Bob264264/Experimental-Mars-Robot/interface/web_interface/electronics/Actuator Data.xlsx

Sheet: Sheet4
SUMMARY OUTPUT
Regression Statistics
Multiple R | 0.9997072639
R Square | 0.9994146135
Adjusted R Square | 0.9993755878
Standard Error | 0.6669676652
Observations | 17
ANOVA
 | df | SS | MS | F | Significance F
Regression | 1 | 11392.10154 | 11392.10154 | 25609.09833 | 1.155031198e-25
Residual | 15 | 6.672687996 | 0.4448458664
Total | 16 | 11398.77422
 | Coefficients | Standard Error | t Stat | P-value | Lower 95% | Upper 95% | Lower 95.0% | Upper 95.0%
Intercept | 0.5874132888 | 0.4841623047 | 1.213256966 | 0.2437918728 | -0.4445542356 | 1.619380813 | -0.4445542356 | 1.619380813
X Variable 1 | 0.8996115754 | 0.005621573471 | 160.0284298 | 1.155031198e-25 | 0.8876294752 | 0.9115936756 | 0.8876294752 | 0.9115936756
RESIDUAL OUTPUT
Observation | Predicted Y | Residuals
1 | 63.56022357 | 0.7197764313
2 | 77.0543972 | -1.2843972
3 | 90.54857083 | 0.3114291684
4 | 104.0427445 | 0.307255537
5 | 77.0543972 | -0.9243972002
6 | 108.5408023 | 0.6391976598
7 | 54.56410781 | -0.08410781446
8 | 81.55245508 | -0.7924550773
9 | 104.0427445 | -0.212744463
10 | 45.56799206 | 0.6620079398
11 | 41.06993418 | -0.569934183
12 | 72.55633932 | -0.676339323
13 | 90.54857083 | 0.5914291684
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
