Bob264264/Experimental-Mars-Robot/interface/recognition/image/image1.png

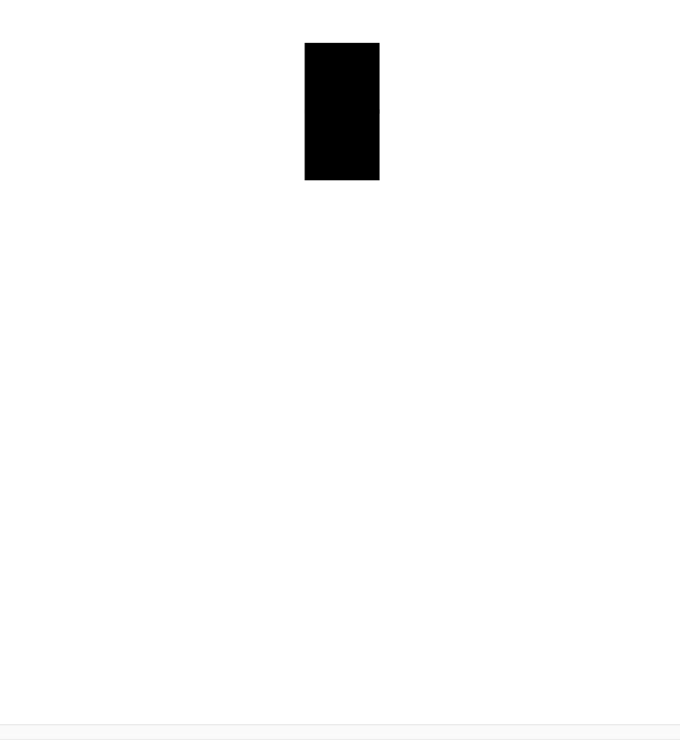
interface/recognition/image/image1.png
