Bob264264/Experimental-Mars-Robot/interface/recognition/image/image2.png

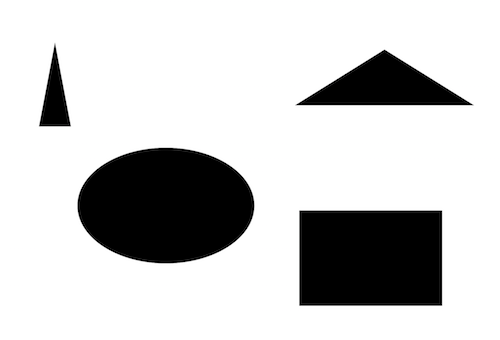
interface/recognition/image/image2.png
