Bob264264/Experimental-Mars-Robot/interface/recognition/template/template1.png

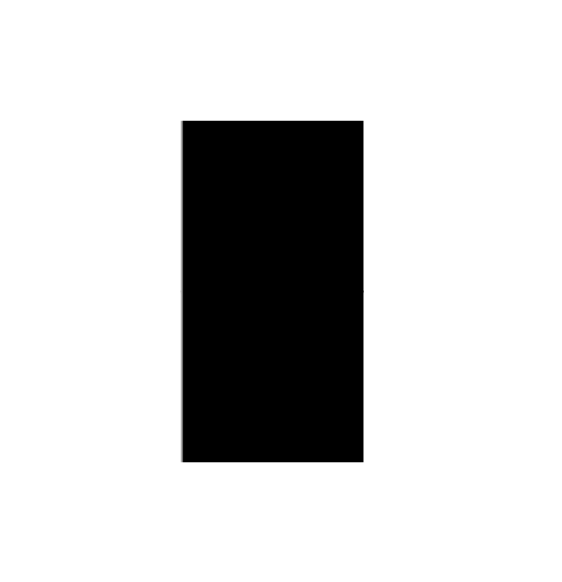
interface/recognition/template/template1.png
