Bob264264/Experimental-Mars-Robot/interface/recognition/template/template2.png

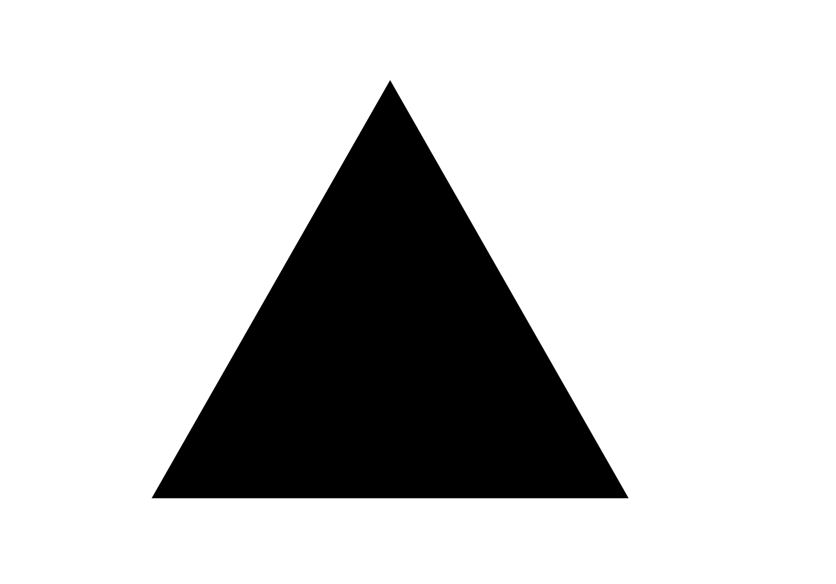
interface/recognition/template/template2.png
