Bob264264/Experimental-Mars-Robot/models/actuator/actuator assembly.SLDASM

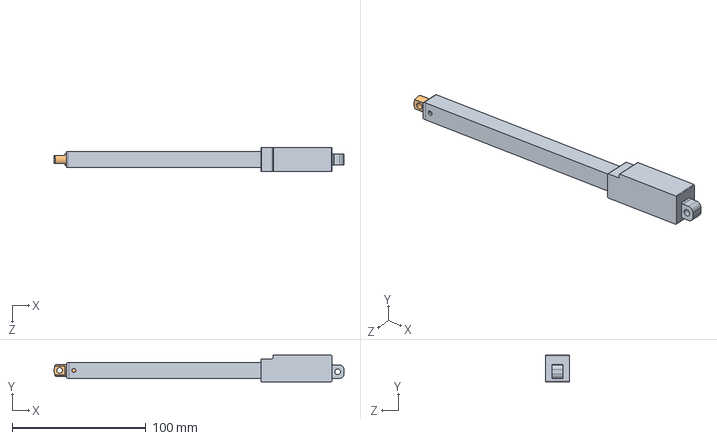
[picture p18: CAD file, 2016-07-16]
models/actuator/actuator assembly.SLDASM
217.0 x 20.0 x 18.0 mm
actuator body
actuator arm
