Bob264264/Experimental-Mars-Robot/models/wheel design v4/wheel UNDIMENSIONED.SLDASM

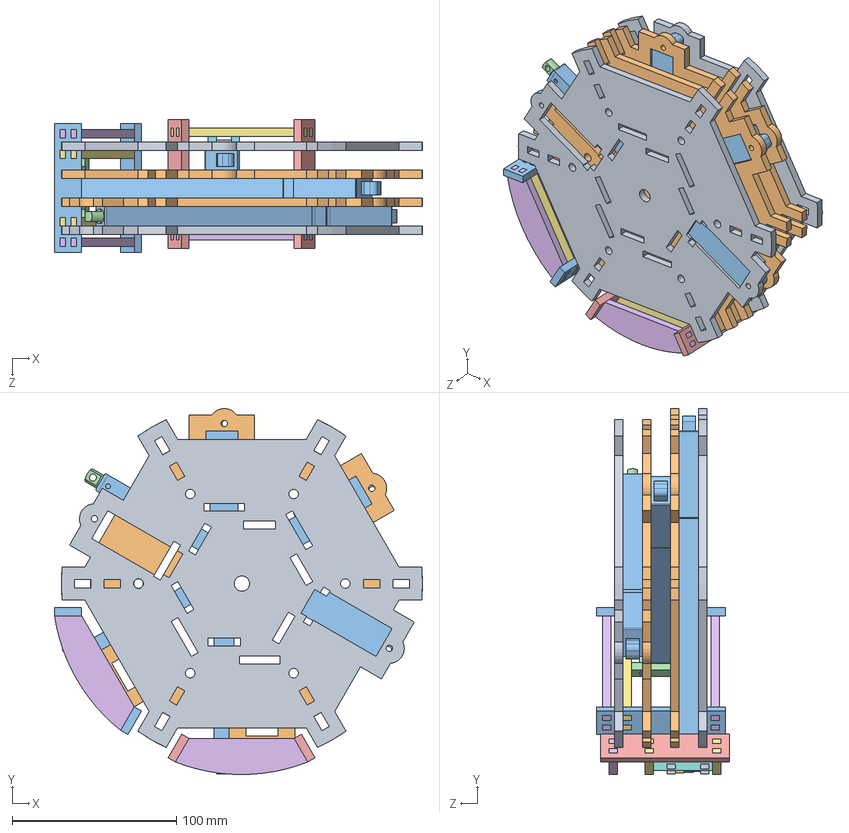
[picture p19: CAD file, 2016-07-16]
models/wheel design v4/wheel UNDIMENSIONED.SLDASM
224.2 x 223.0 x 80.9 mm
end wheel plate UNDIMENSIONED x 2
center wheel plate UNDIMENSIONED x 2
actuator body x 3
actuator arm x 3
OuterActuatorSidePlate x 2
SpanningPlate x 3
ConnectingPlate x 4
OuterActuatorSpanner x 2
SpacerBoltConnector x 4
A-Spacer x 4
CentralActuatorSidePlate x 2
CentralActuatorSpanner x 2
