Bob264264/Experimental-Mars-Robot/models/wheel design v4/foot/newFootAssemblyForEndActuators.SLDASM

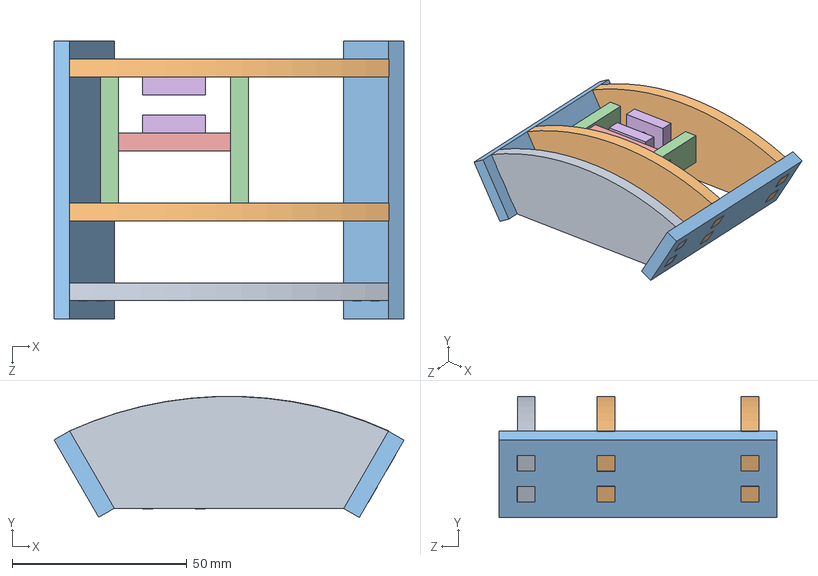
[picture p20: CAD file, 2016-07-16]
models/wheel design v4/foot/newFootAssemblyForEndActuators.SLDASM
100.0 x 34.6 x 79.4 mm
newFootWithTabs
newFootWithTabsWithCutout x 2
newFootConnector x 2
connectorToMidPlateAndEndPlate - Copy x 2
connectorToSpacerA
spacerA x 2
