Bob264264/Experimental-Mars-Robot/models/wheel design v4/foot/centralFootAssembly.SLDASM

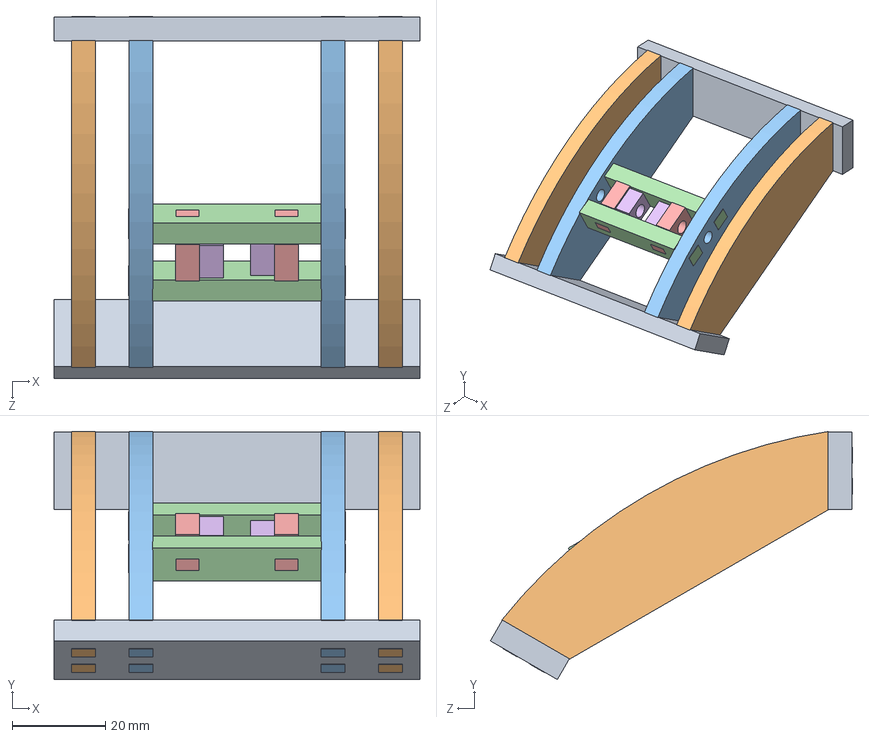
[picture p21: CAD file, 2016-07-16]
models/wheel design v4/foot/centralFootAssembly.SLDASM
78.4 x 53.2 x 77.6 mm
CentralActuatorSidePlate x 2
SpanningPlate x 2
ConnectingPlate x 2
CentralActuatorSpanner x 2
SpacerBoltConnector x 2
A-Spacer x 2
