Bob264264/Experimental-Mars-Robot/models/wheel design v4/foot/outerFootAssembly.SLDASM

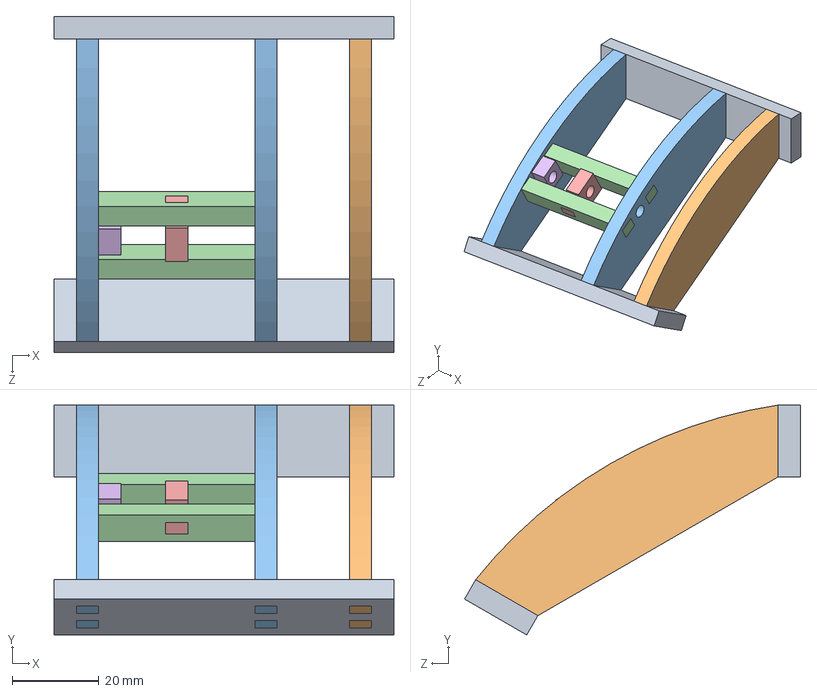
[picture p22: CAD file, 2016-07-16]
models/wheel design v4/foot/outerFootAssembly.SLDASM
78.4 x 53.0 x 77.5 mm
OuterActuatorSidePlate x 2
SpanningPlate
ConnectingPlate x 2
OuterActuatorSpanner x 2
SpacerBoltConnector
A-Spacer
