Bob264264/Experimental-Mars-Robot/models/wheel design v4/foot/newFootAssemblyMiddleActuators.SLDASM

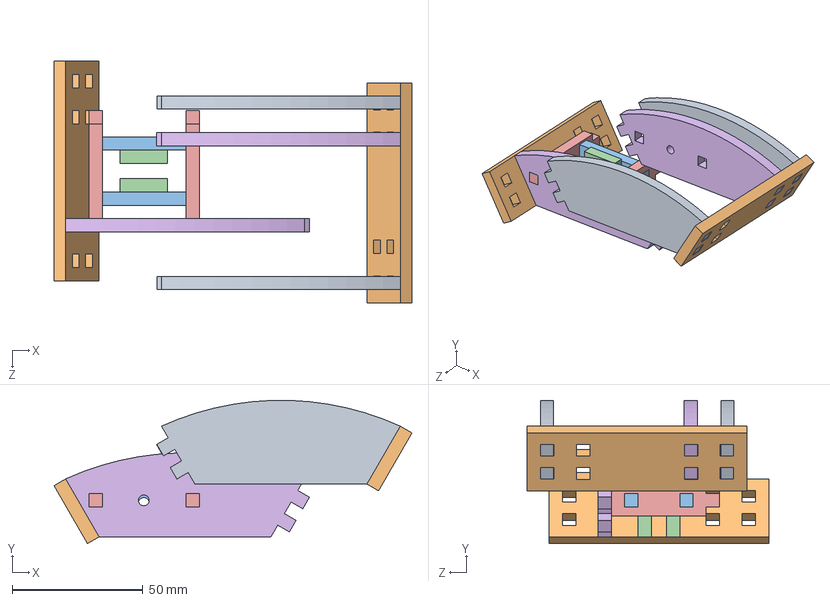
[picture p24: CAD file, 2016-07-12]
models/wheel design v4/foot/newFootAssemblyMiddleActuators.SLDASM
136.7 x 54.7 x 92.3 mm
newFootWithTabs x 2
newFootConnectorForMiddlePlate x 2
connectorToSpacerA x 2
spacerA x 2
connectorToMidPlatesAndConnector x 2
newFootWithTabsWithCutout x 2
