Bob264264/Experimental-Mars-Robot/models/wheel design v4/foot/actuatorAttachmentAssembly.SLDASM

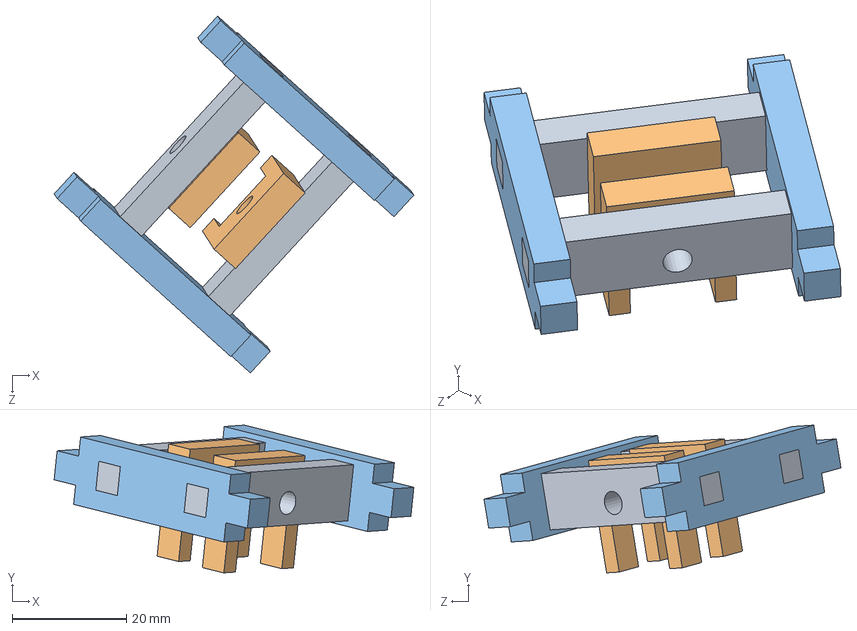
[picture p25: CAD file, 2016-07-11]
models/wheel design v4/foot/actuatorAttachmentAssembly.SLDASM
62.9 x 25.9 x 62.4 mm
connectorToSpacerA x 2
spacerA x 2
connectorToMidPlatesAndConnector x 2
