Bob264264/Experimental-Mars-Robot/models/wheel design v4/drawings/proximal_actuator_shaft_support_center.DXF

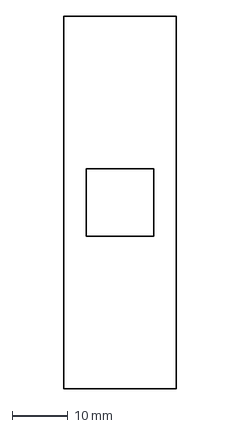
[picture p26: CAD file, 2016-07-13]
models/wheel design v4/drawings/proximal_actuator_shaft_support_center.DXF
20.2 x 67.0 mm
