Bob264264/Experimental-Mars-Robot/models/wheel design v4/end wheel plate UNDIMENSIONED.SLDPRT

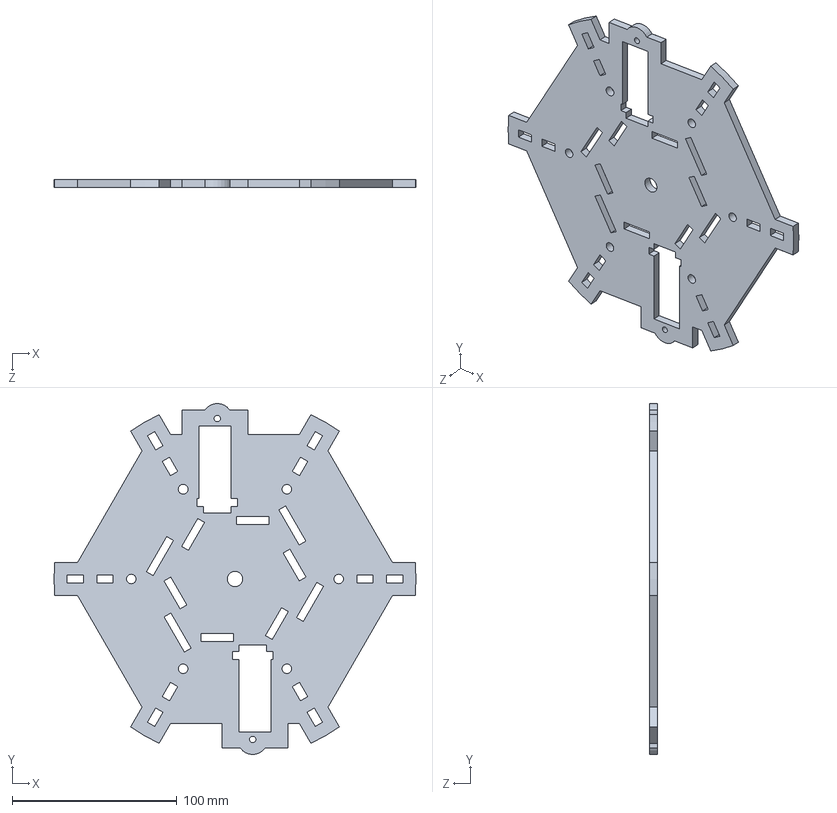
[picture p27: CAD file, 2016-07-16]
models/wheel design v4/end wheel plate UNDIMENSIONED.SLDPRT
220.0 x 213.3 x 5.15 mm
