Bob264264/Experimental-Mars-Robot/models/wheel design v4/foot/CentralActuatorSpanner.SLDPRT

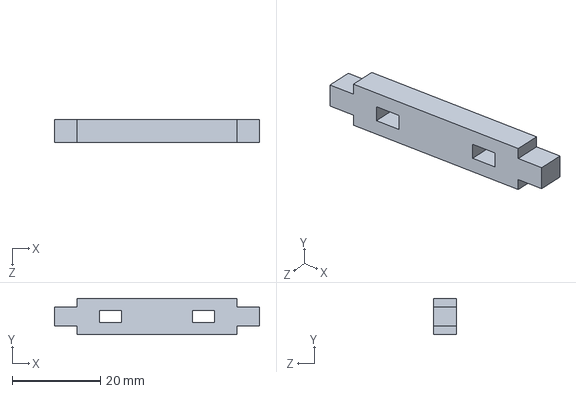
[picture p28: CAD file, 2016-07-16]
models/wheel design v4/foot/CentralActuatorSpanner.SLDPRT
46.5 x 8.20 x 5.15 mm
