Bob264264/Experimental-Mars-Robot/models/wheel design v4/foot/kerfed/A-Spacer.DXF

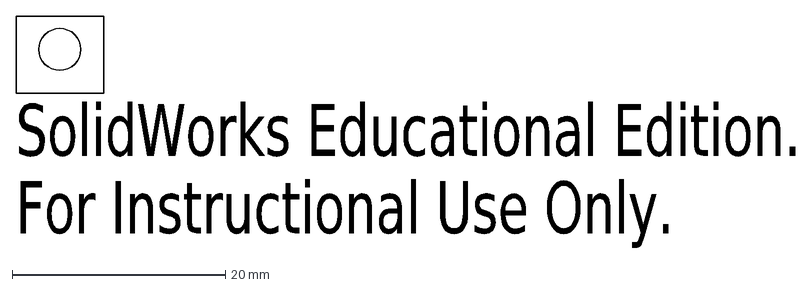
[picture p29: CAD file, 2016-07-16]
models/wheel design v4/foot/kerfed/A-Spacer.DXF
SolidWorks Educational Edition.
For Instructional Use Only.
