Bob264264/Experimental-Mars-Robot/models/actuator/actuator body.SLDPRT

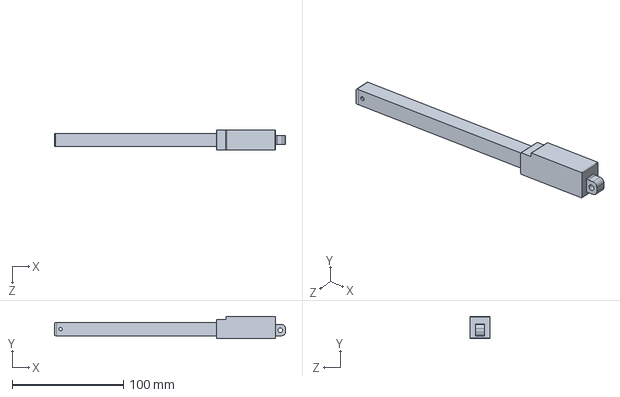
[picture p30: CAD file, 2016-07-13]
models/actuator/actuator body.SLDPRT
207.7 x 20.0 x 18.0 mm
