Bob264264/Experimental-Mars-Robot/models/wheel design v4/drawings/distal_e_connector_bracket.DXF

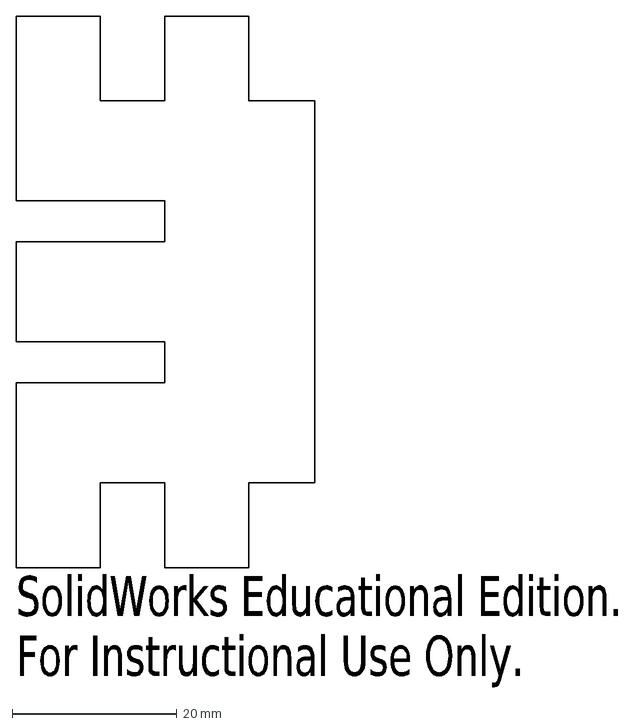
[picture p31: CAD file, 2016-07-13]
models/wheel design v4/drawings/distal_e_connector_bracket.DXF
SolidWorks Educational Edition.
For Instructional Use Only.
