Bob264264/Experimental-Mars-Robot/models/wheel design v4/foot/CentralActuatorSidePlate.SLDPRT

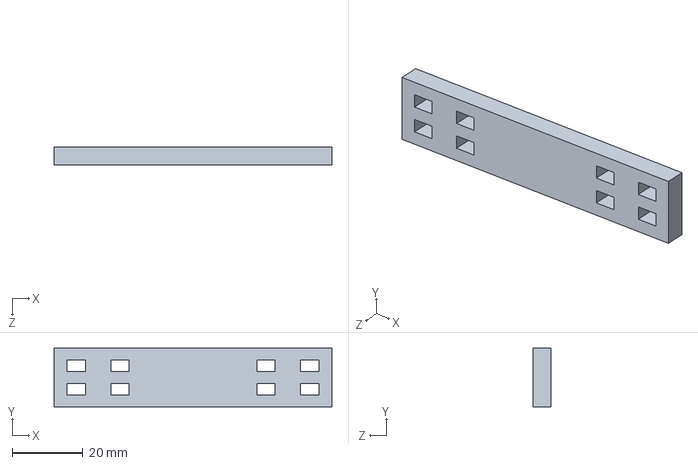
[picture p32: CAD file, 2016-07-16]
models/wheel design v4/foot/CentralActuatorSidePlate.SLDPRT
78.4 x 16.6 x 5.15 mm
