Bob264264/Experimental-Mars-Robot/models/actuator/actuator arm.SLDPRT

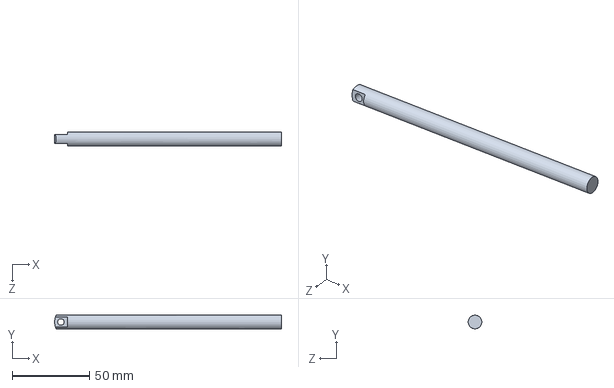
[picture p34: CAD file, 2016-07-11]
models/actuator/actuator arm.SLDPRT
147.3 x 8.90 x 8.90 mm
