Bob264264/Experimental-Mars-Robot/models/wheel design v4/drawings/proximal_actuator_body_support_center.DXF

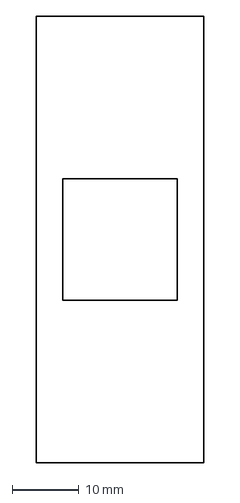
[picture p35: CAD file, 2016-07-13]
models/wheel design v4/drawings/proximal_actuator_body_support_center.DXF
25.2 x 67.0 mm
