Bob264264/Experimental-Mars-Robot/models/wheel design v4/foot/kerfed/CentralActuatorSpanner.DXF

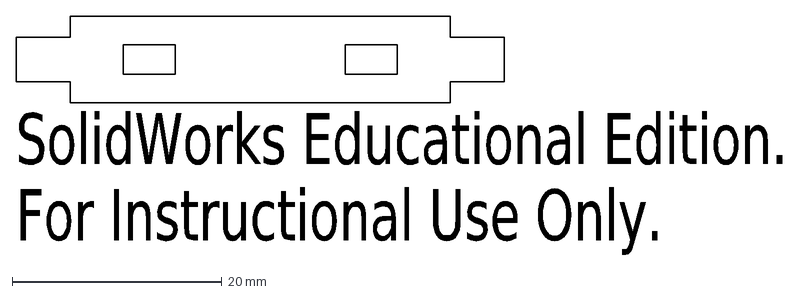
[picture p37: CAD file, 2016-07-16]
models/wheel design v4/foot/kerfed/CentralActuatorSpanner.DXF
SolidWorks Educational Edition.
For Instructional Use Only.
