Bob264264/Experimental-Mars-Robot/models/actuator/actuator mounting bracket.SLDPRT

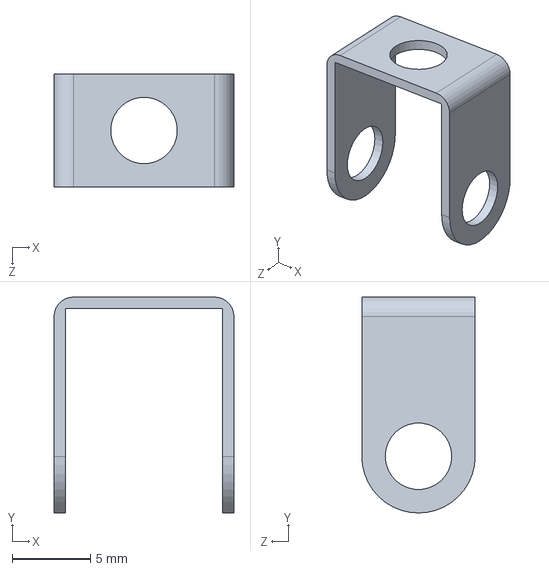
[picture p38: CAD file, 2016-07-03]
models/actuator/actuator mounting bracket.SLDPRT
11.5 x 13.8 x 7.25 mm
