Bob264264/Experimental-Mars-Robot/models/wheel design v4/foot/OuterActuatorSidePlate.SLDPRT

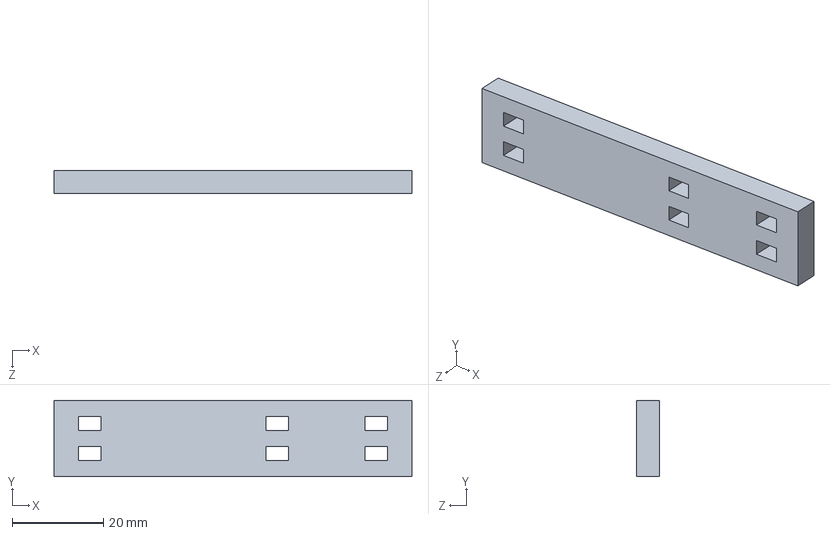
[picture p41: CAD file, 2016-07-16]
models/wheel design v4/foot/OuterActuatorSidePlate.SLDPRT
78.6 x 16.8 x 5.15 mm
