Bob264264/Experimental-Mars-Robot/models/wheel design v4/central wheel plate.SLDPRT

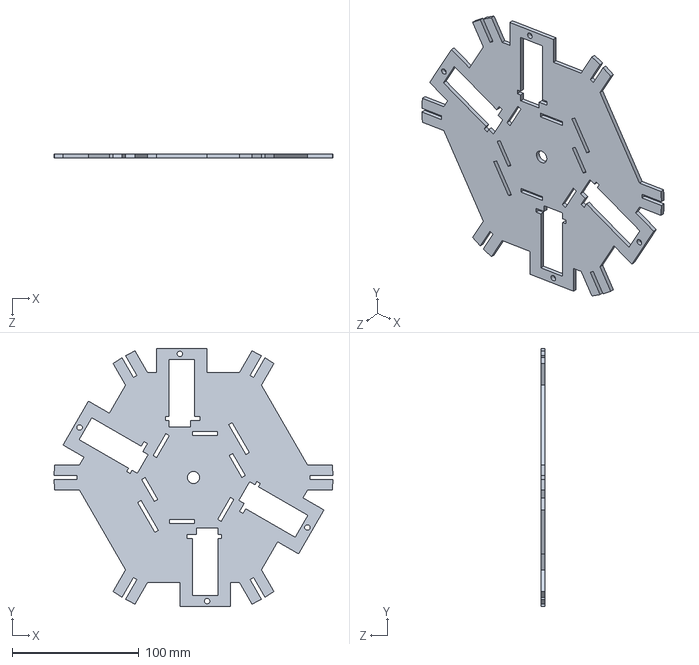
[picture p42: CAD file, 2016-07-13]
models/wheel design v4/central wheel plate.SLDPRT
220.0 x 203.8 x 3.17 mm
