Bob264264/Experimental-Mars-Robot/models/wheel design v4/drawings/end_wheel plate.DXF

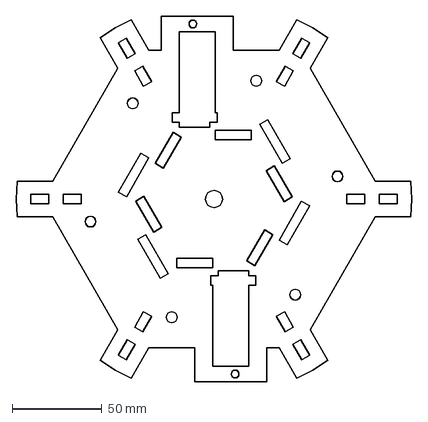
[picture p43: CAD file, 2016-07-13]
models/wheel design v4/drawings/end_wheel plate.DXF
220.3 x 203.7 mm
