Bob264264/Experimental-Mars-Robot/models/wheel design v4/foot/SpanningPlate.SLDPRT

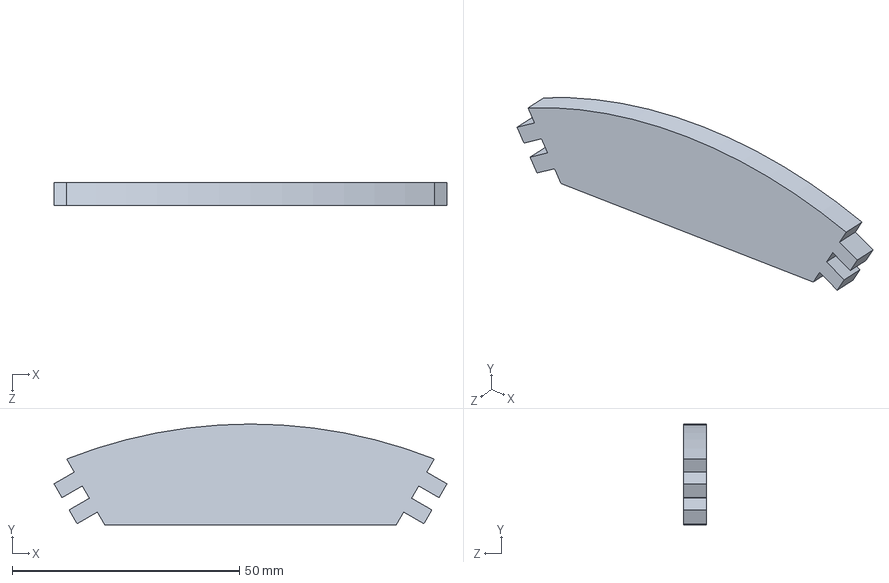
[picture p45: CAD file, 2016-07-16]
models/wheel design v4/foot/SpanningPlate.SLDPRT
86.5 x 22.2 x 5.15 mm
