Bob264264/Experimental-Mars-Robot/models/wheel design v4/drawings/proximal_actuator_shaft_support_side.DXF

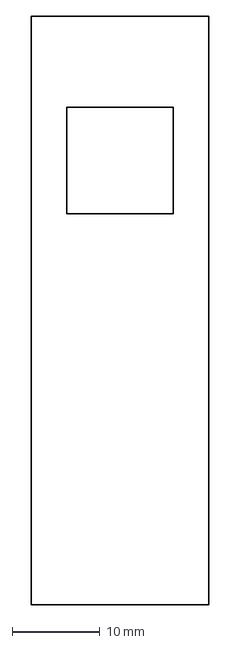
[picture p46: CAD file, 2016-07-13]
models/wheel design v4/drawings/proximal_actuator_shaft_support_side.DXF
20.2 x 67.0 mm
