Bob264264/Experimental-Mars-Robot/models/wheel design v4/proximal actuator shaft support side.SLDPRT

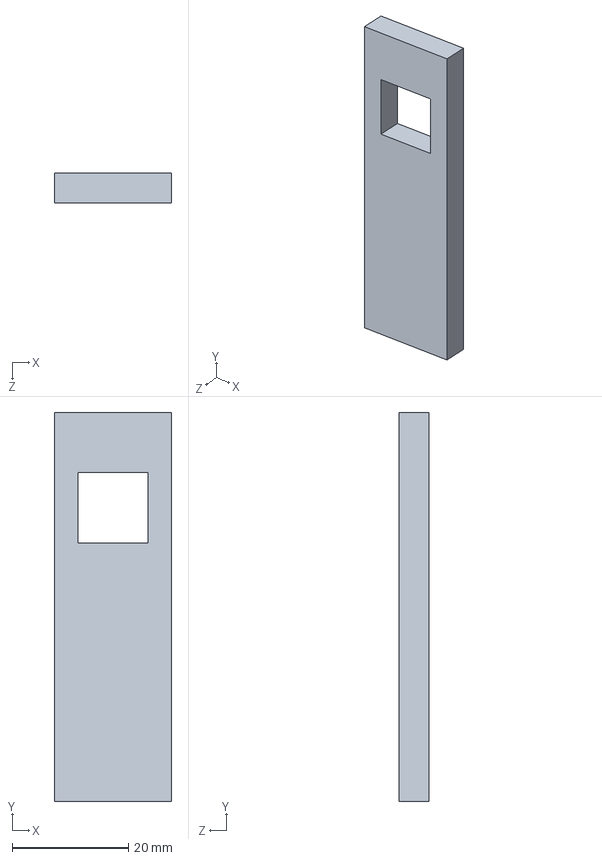
[picture p48: CAD file, 2016-07-13]
models/wheel design v4/proximal actuator shaft support side.SLDPRT
20.2 x 67.1 x 5.20 mm
