Bob264264/Experimental-Mars-Robot/models/wheel design v4/proximal actuator body support center.SLDPRT

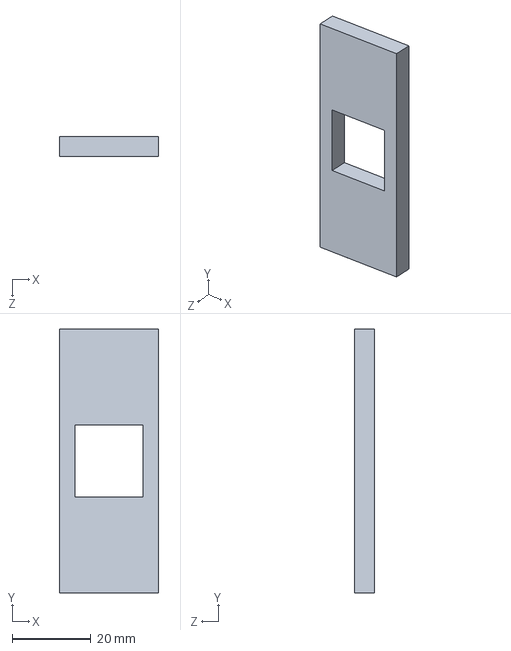
[picture p50: CAD file, 2016-07-13]
models/wheel design v4/proximal actuator body support center.SLDPRT
25.2 x 67.1 x 5.20 mm
