Bob264264/Experimental-Mars-Robot/models/wheel design v4/end wheel plate.SLDPRT

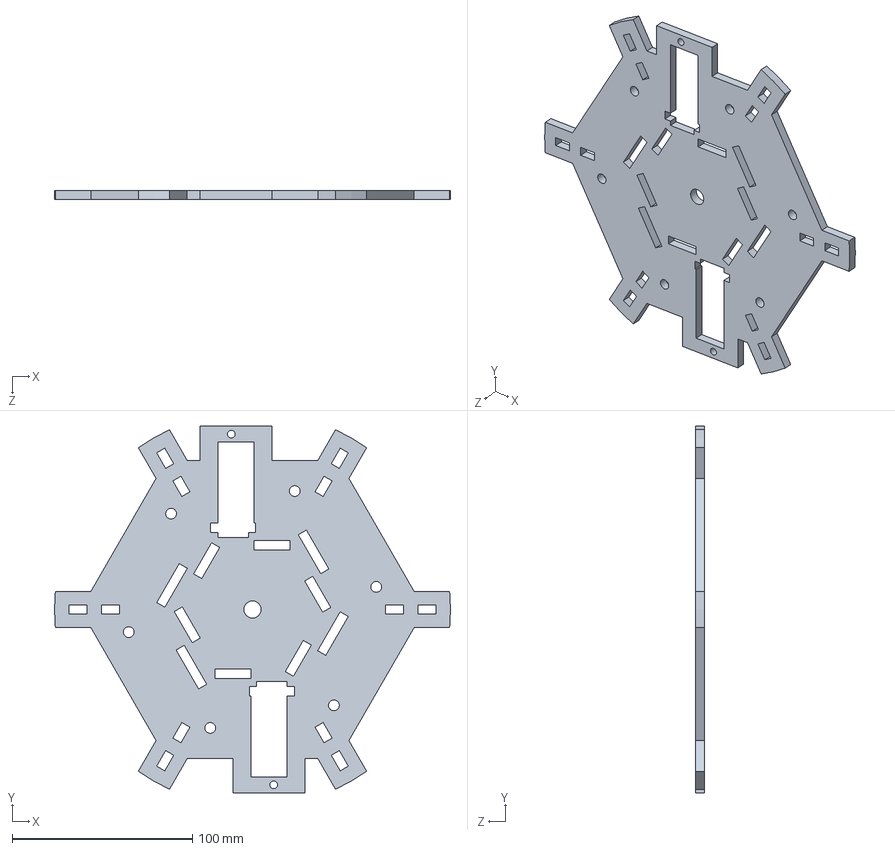
[picture p51: CAD file, 2016-07-13]
models/wheel design v4/end wheel plate.SLDPRT
220.0 x 203.7 x 5.20 mm
