Bob264264/Experimental-Mars-Robot/models/wheel design v4/foot/A-Spacer.SLDPRT

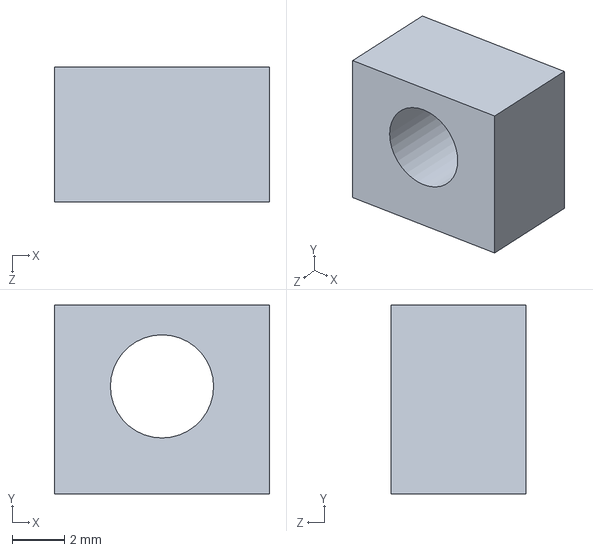
[picture p52: CAD file, 2016-07-16]
models/wheel design v4/foot/A-Spacer.SLDPRT
8.20 x 7.20 x 5.15 mm
