Bob264264/Experimental-Mars-Robot/models/wheel design v4/distal E connector bracket.SLDPRT

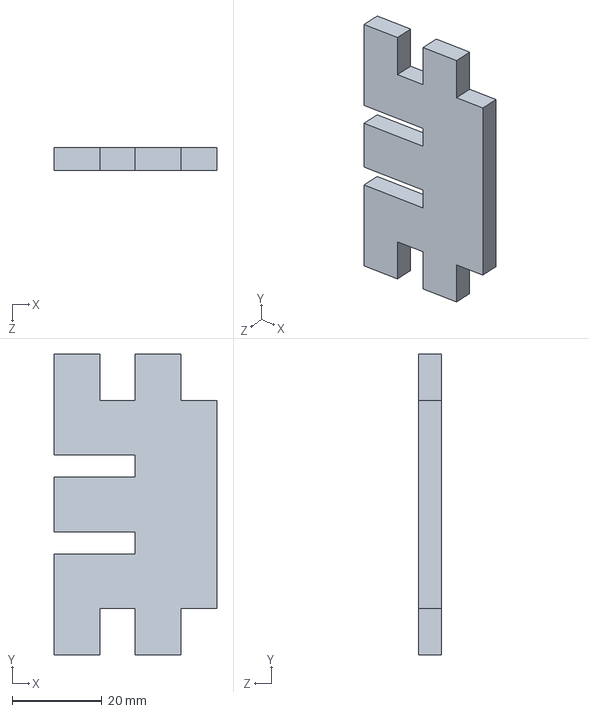
[picture p53: CAD file, 2016-07-13]
models/wheel design v4/distal E connector bracket.SLDPRT
36.2 x 67.0 x 5.15 mm
