Bob264264/Experimental-Mars-Robot/models/wheel design v4/foot/OuterActuatorSpanner.SLDPRT

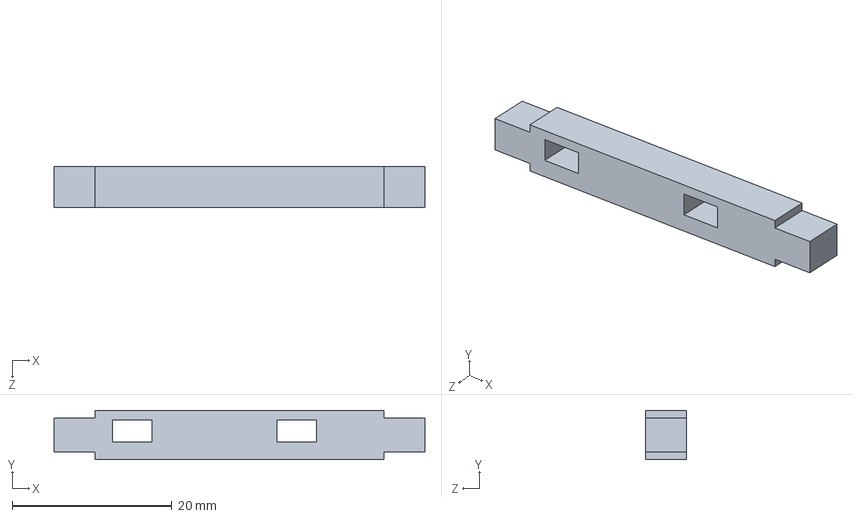
[picture p54: CAD file, 2016-07-16]
models/wheel design v4/foot/OuterActuatorSpanner.SLDPRT
46.5 x 6.20 x 5.15 mm
