Bob264264/Experimental-Mars-Robot/models/wheel design v4/foot/newFootWithTabsWithCutout.SLDPRT

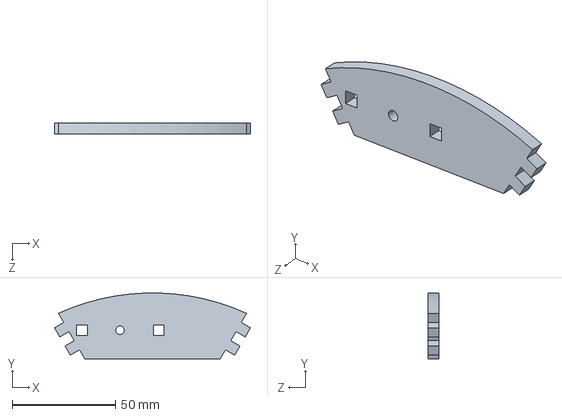
[picture p55: CAD file, 2016-07-11]
models/wheel design v4/foot/newFootWithTabsWithCutout.SLDPRT
95.0 x 32.0 x 5.15 mm
