Bob264264/Experimental-Mars-Robot/models/wheel design v4/foot/connectorToMidPlatesAndConnector.SLDPRT

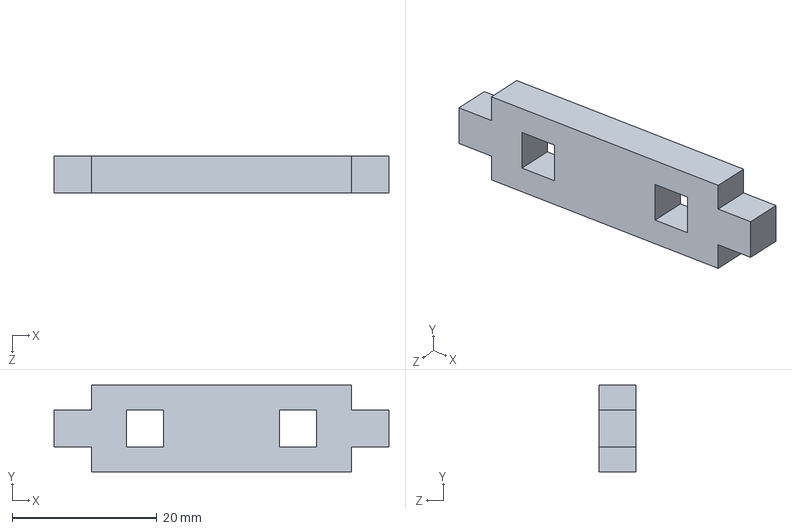
[picture p56: CAD file, 2016-07-11]
models/wheel design v4/foot/connectorToMidPlatesAndConnector.SLDPRT
46.3 x 12.0 x 5.15 mm
