Bob264264/Experimental-Mars-Robot/models/wheel design v4/foot/connectorToSpacerA.SLDPRT

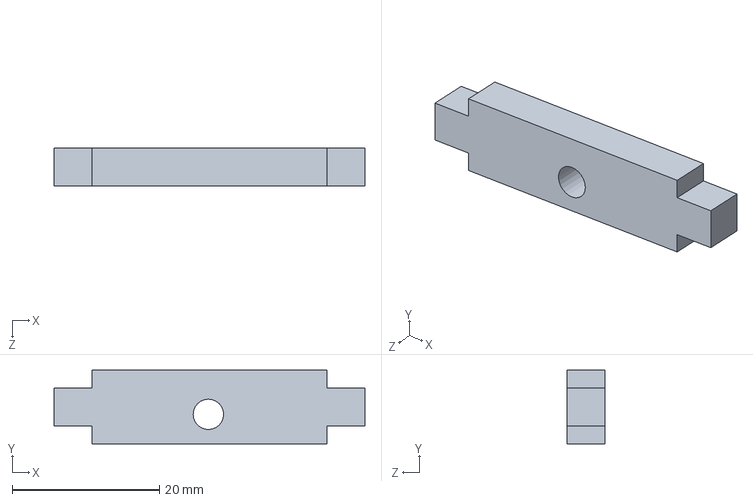
[picture p57: CAD file, 2016-07-11]
models/wheel design v4/foot/connectorToSpacerA.SLDPRT
42.3 x 10.0 x 5.15 mm
