Bob264264/Experimental-Mars-Robot/models/wheel design v4/foot/newFootConnector.SLDPRT

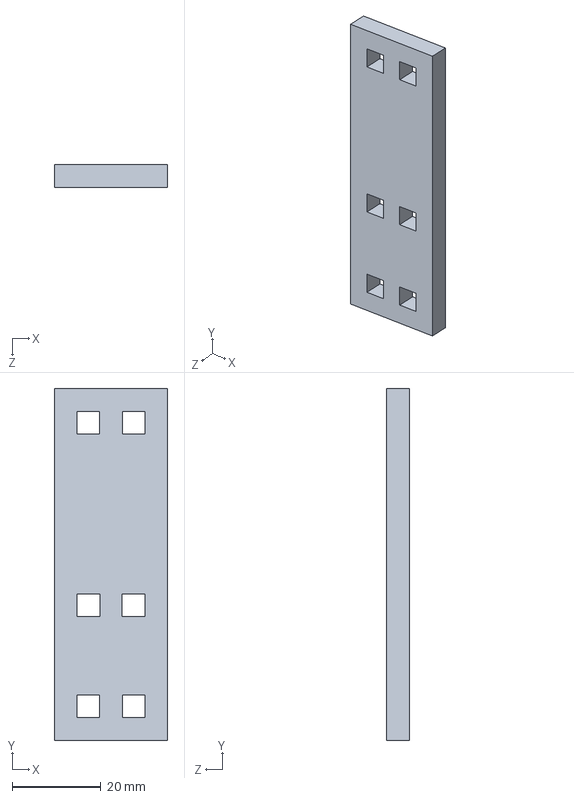
[picture p58: CAD file, 2016-07-11]
models/wheel design v4/foot/newFootConnector.SLDPRT
25.5 x 79.4 x 5.15 mm
