Bob264264/Experimental-Mars-Robot/models/wheel design v4/foot/connectorToMidPlateAndEndPlate - Copy.SLDPRT

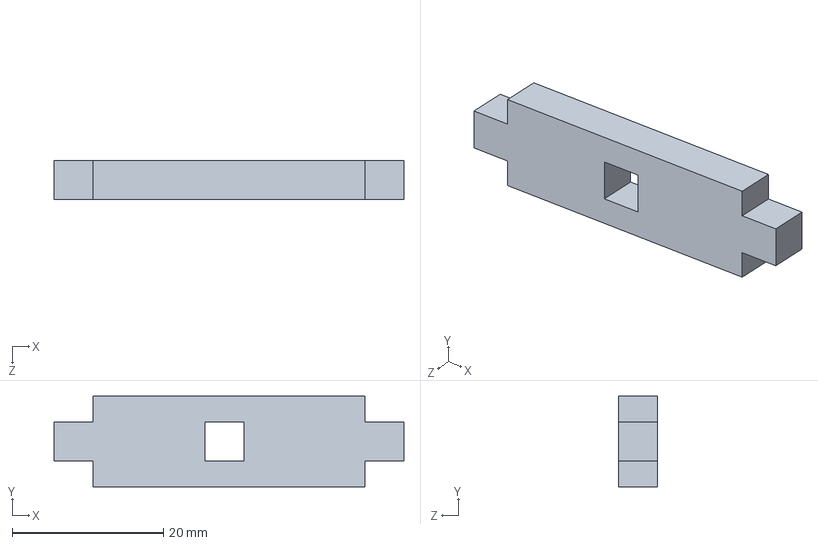
[picture p59: CAD file, 2016-07-11]
models/wheel design v4/foot/connectorToMidPlateAndEndPlate - Copy.SLDPRT
46.3 x 12.0 x 5.15 mm
