Bob264264/Experimental-Mars-Robot/models/wheel design v4/foot/spacerA.SLDPRT

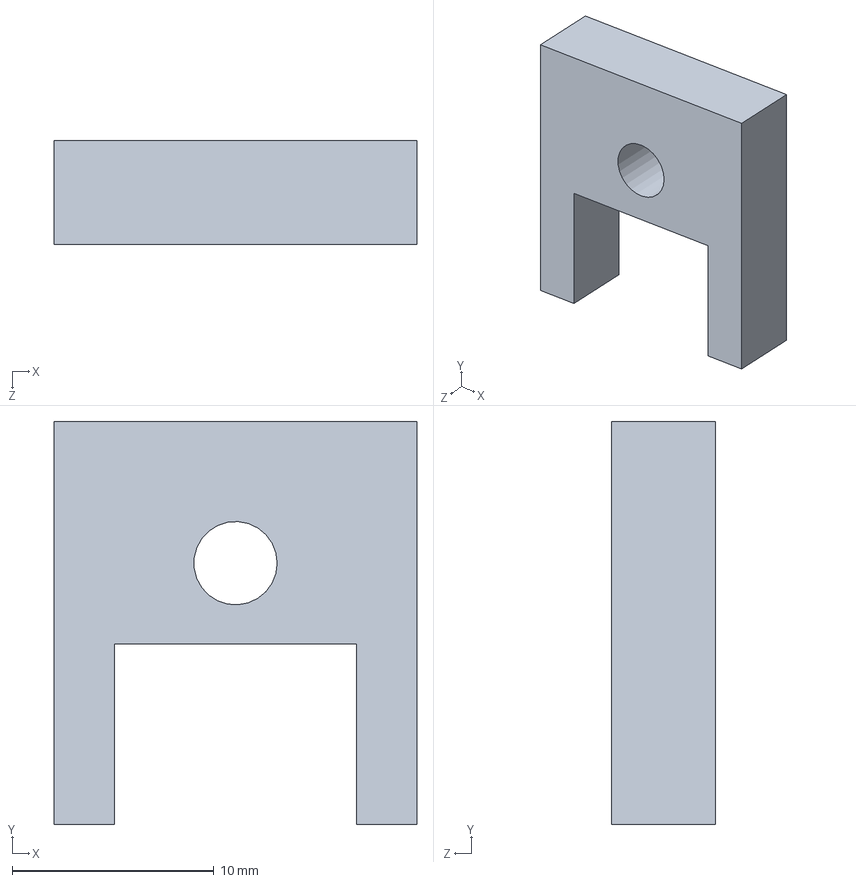
[picture p60: CAD file, 2016-07-11]
models/wheel design v4/foot/spacerA.SLDPRT
18.0 x 20.0 x 5.15 mm
