Bob264264/Experimental-Mars-Robot/models/wheel design v4/foot/newFootConnectorForMiddlePlate.SLDPRT

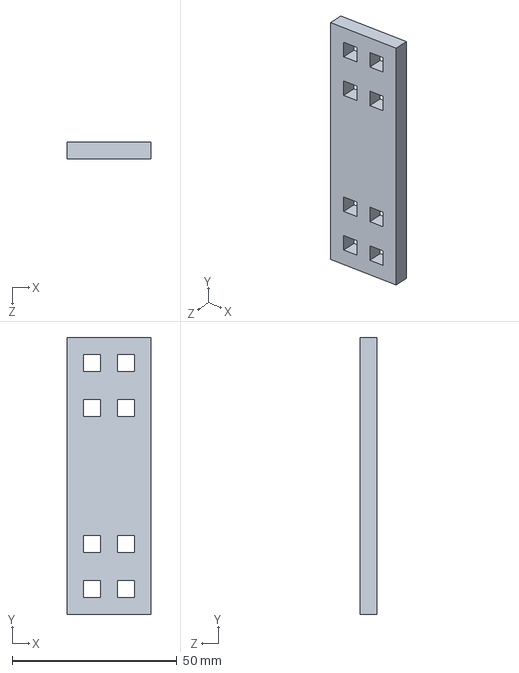
[picture p61: CAD file, 2016-07-11]
models/wheel design v4/foot/newFootConnectorForMiddlePlate.SLDPRT
25.5 x 84.0 x 5.15 mm
