Bob264264/Experimental-Mars-Robot/models/wheel design v4/foot/newFootWithTabs.SLDPRT

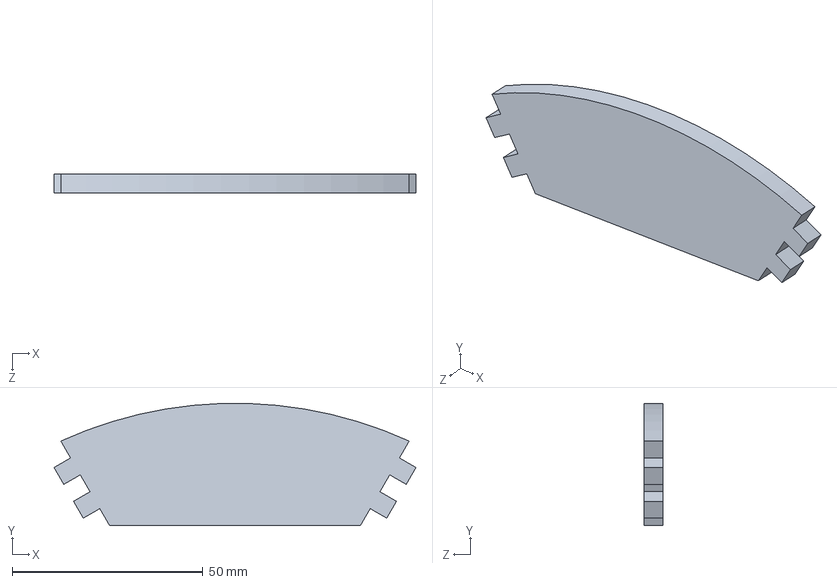
[picture p62: CAD file, 2016-07-11]
models/wheel design v4/foot/newFootWithTabs.SLDPRT
94.8 x 32.0 x 5.00 mm
