Bob264264/Experimental-Mars-Robot/models/wheel design v4/foot/newFootWithTabsWithCutoutMiddleActuator.SLDPRT

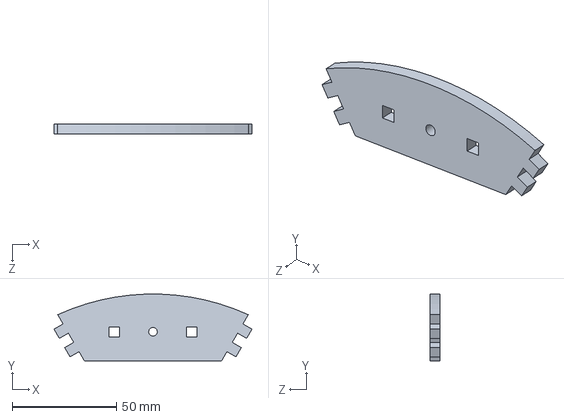
[picture p63: CAD file, 2016-07-10]
models/wheel design v4/foot/newFootWithTabsWithCutoutMiddleActuator.SLDPRT
94.8 x 32.0 x 5.00 mm
