Bob264264/Experimental-Mars-Robot/models/wheel design v4/foot/footFaceWithCutout.SLDPRT

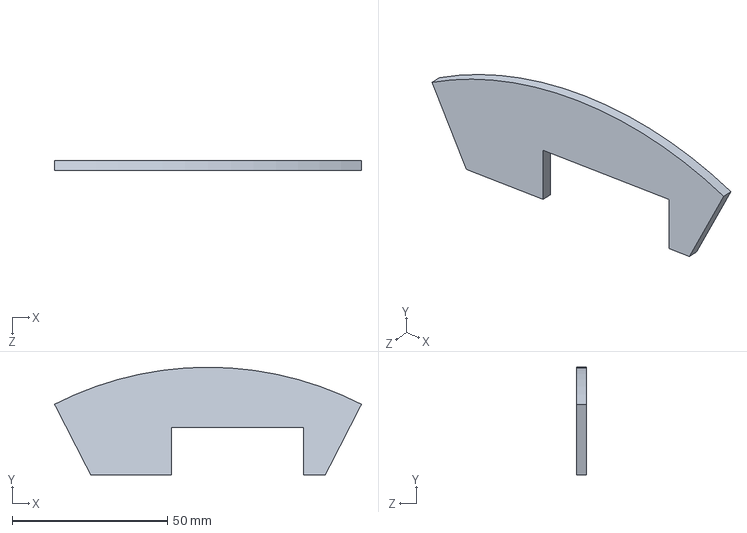
[picture p64: CAD file, 2016-07-07]
models/wheel design v4/foot/footFaceWithCutout.SLDPRT
99.0 x 34.7 x 3.17 mm
