Bob264264/Experimental-Mars-Robot/models/wheel design v4/foot/footFaceWithoutCutout.SLDPRT

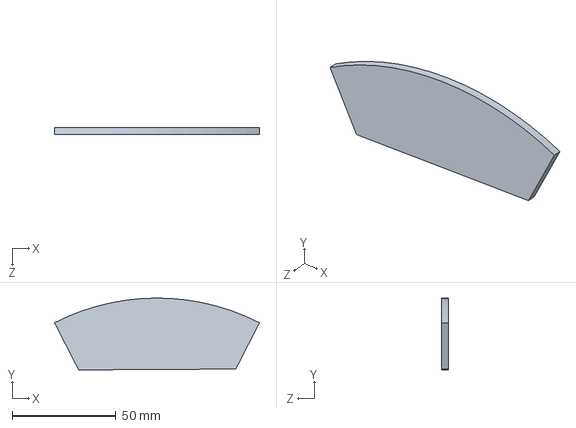
[picture p65: CAD file, 2016-07-07]
models/wheel design v4/foot/footFaceWithoutCutout.SLDPRT
98.8 x 34.6 x 3.17 mm
