Bob264264/Experimental-Mars-Robot/(list of files, cad)

Other CAD files:
models/wheel design v4/center wheel plate UNDIMENSIONED.SLDPRT
models/wheel design v4/proximal actuator shaft support center.SLDPRT
models/wheel design v4/proximal actuator body support side.SLDPRT
models/actuator/actuator body.x_t
models/actuator/actuatorBody.IGS
models/wheel design v1/actuator cage and actuator.SLDASM
models/wheel design v1/actuator cage base.SLDPRT
models/wheel design v1/actuator cage side wall 1.SLDPRT
models/wheel design v1/actuator cage side wall 2.SLDPRT
models/wheel design v1/actuator cage.SLDASM
models/wheel design v1/hexagonal plate connector.SLDPRT
models/wheel design v1/panel to plate connection.SLDPRT
models/wheel design v1/plank assembly.SLDASM
models/wheel design v1/plank set 1 (left).SLDPRT
models/wheel design v1/plank set 1 and plate connectors.SLDASM
models/wheel design v1/plank set 1 with plate connectors and actuator.SLDASM
models/wheel design v1/plank set 2 (center).SLDPRT
models/wheel design v1/plank set 2 and plate connectors.SLDASM
models/wheel design v1/plank set 2 with plate connectors and actuator.SLDASM
models/wheel design v1/plank set template.SLDPRT
models/wheel design v1/wheel plate.SLDPRT
models/wheel design v1/wheel.SLDASM
models/wheel design v2/plank set 1 (left, right).SLDPRT
models/wheel design v2/plank set 2 (center).SLDPRT
models/wheel design v2/plank set template.SLDPRT
models/wheel design v3/middle plate.SLDPRT
models/wheel design v3/wheel without end plates.SLDASM
models/wheel design v3/wheel.SLDASM
models/wheel design v4/foot/SpacerBoltConnector.SLDPRT
models/wheel design v4/foot/kerfed/SpacerBoltConnector.DXF
