Bob264264/Experimental-Mars-Robot/(commit log)

2016-07-03 Added 3D models
    [actuator arm.SLDPRT, actuator assembly.SLDASM, actuator body.SLDPRT, actuator mounting bracket.SLDPRT, actuator set 1 (left) plate 1.SLDPRT, actuator set 2 (center) plate 1.SLDPRT, actuator set 3 (right) plate 1.SLDPRT, actuator set plate 1 template.SLDPRT]
2016-07-03 Added triangular wedge
    [panel to plate connection.SLDPRT]
2016-07-03 Deleted separate plank templates
    I'm a dumbass and realized that the plates for each set are basically
    the same.
    [actuator set 1 (left) plate 1.SLDPRT, actuator set 2 (center) plate 1.SLDPRT, actuator set 3 (right) plate 1.SLDPRT, plank set template.SLDPRT]
2016-07-04 Committing the day's work
    Only some parts of the actuator cage are left to be designed.
    [actuator cage base.SLDPRT, actuator cage side wall 1.SLDPRT, actuator cage support wedge.SLDPRT, panel to plate connection.SLDPRT, plank set 1 (left).SLDPRT, plank set 2 (center).SLDPRT, plank set 3 (right).SLDPRT, plank set template.SLDPRT]
2016-07-04 Finished actuator cage
    [actuator cage base.SLDPRT, actuator cage side wall 1.SLDPRT, actuator cage side wall 2.SLDPRT, actuator cage support wedge.SLDPRT]
2016-07-04 Actuator cage assembly
    [actuator cage support wedge.SLDPRT, actuator cage.SLDASM]
2016-07-04 Remodeled actuator cage
    Need to fit the hole in the actuator cage base appropriately to the
    dimensions of the little "nub" at the end of the actuator body. This
    will be need to be done by real-life dimensioning the actuator.
    [actuator cage base.SLDPRT, actuator cage side wall 1.SLDPRT, actuator cage side wall 2.SLDPRT, actuator cage support wedge.SLDPRT, actuator cage.SLDASM, hexagonal plate connector.SLDPRT, plank set 1 (left).SLDPRT, plank set 2 (center).SLDPRT]
2016-07-04 Added planks back
    [plank set 1 (left).SLDPRT, plank set 2 (center).SLDPRT, plank set 3 (right).SLDPRT]
2016-07-04 Actuator cage and actuator
    Requires some edits on the bottom base once the actuator can be
    re-measured.
    [actuator assembly.SLDASM, actuator cage and actuator.SLDASM, actuator cage base.SLDPRT, actuator cage side wall 1.SLDPRT, actuator cage side wall 2.SLDPRT, actuator cage.SLDASM, plank set 1 and plate connectors.SLDASM, plank set 2 and plate connectors.SLDASM]
2016-07-04 Foot models
    [footBase.SLDPRT, footConnector.SLDPRT]
2016-07-05 Modified cage to fit planks
    [actuator cage and actuator.SLDASM, actuator cage base.SLDPRT, actuator cage side wall 1.SLDPRT, actuator cage side wall 2.SLDPRT, actuator cage.SLDASM, hexagonal plate connector.SLDPRT, plank set 1 (left).SLDPRT, plank set 1 and plate connectors.SLDASM]
2016-07-05 Realized the wheel design is messed up
    It doesn't allow the actuators to touch the ground in their fully
    extended state. Need to edit planks so that they can include the
    actuator body, which will allow for a further extension over the wheel
    edge.
    [actuator assembly.SLDASM, actuator cage and actuator.SLDASM, actuator cage base.SLDPRT, actuator cage side wall 1.SLDPRT, actuator cage side wall 2.SLDPRT, actuator cage.SLDASM, hexagonal plate connector.SLDPRT, panel to plate connection.SLDPRT]
2016-07-05 Trying new file configuration
    [actuator assembly.x_b, plank set 1 (left, right).SLDPRT, plank set 2 (center).SLDPRT, plank set template.SLDPRT, wheel.SLDASM]
2016-07-06 Wheel design v3
    [actuator assembly.SLDASM, end plate.SLDPRT, middle plate.SLDPRT, wheel without end plates.SLDASM, wheel.SLDASM]
2016-07-07 Minor changes to things
    [wheel.SLDASM]
2016-07-07 Removed plank
    [wheel without end plates.SLDASM]
2016-07-07 Add files via upload
    new plate with cutouts for foot only
    [newPlate.SLDPRT]
2016-07-07 Moved around files for version 4 of the wheel
    [actuator assembly.x_b, footBase.SLDPRT, footConnector.SLDPRT, wheel plate.SLDPRT]
2016-07-07 Added tabs
    [wheel plate.SLDPRT]
2016-07-07 Work on side plates
    [bounding plate template.SLDPRT, side plate in foot cavity.SLDPRT, wheel plate.SLDPRT]
2016-07-07 Add files via upload
    corrected wheel plate 7/7
    [wheel plate.SLDPRT]
2016-07-10 Wheel version 4
    [actuator assembly.SLDASM, actuator body.SLDPRT, bounding plate template.SLDPRT, bounding plate.DWG, bounding plate.SLDPRT, central wheel plate.DWG, central wheel plate.SLDPRT, distal E connector bracket.DWG]
2016-07-10 Fixed E bracket dimensions
    [distal E connector bracket.SLDPRT]
2016-07-10 Add files via upload
    foot 7/10
    [newFootAssemblyForEndActuators.SLDASM, newFootAssemblyMiddleActuators.SLDASM]
2016-07-10 Add files via upload
    USE THIS ONE!!!!!!!!!!!!!!!
    [newFootAssemblyMiddleActuators.SLDASM]
2016-07-10 Removing temporary files
    [central wheel plate.SLDPRT]
2016-07-11 Add files via upload
    THIS IS THE FINAL ONE!!!!!!!!!!
    [actuatorAttachmentAssembly.SLDASM, connectorToMidPlateAndEndPlate - Copy.SLDPRT, connectorToMidPlatesAndConnector.SLDPRT, connectorToSpacerA.SLDPRT, newFootAssemblyForEndActuators.SLDASM, newFootAssemblyMiddleActuators.SLDASM, newFootConnector.SLDPRT, newFootConnectorForMiddlePlate.SLDPRT]
2016-07-11 Work so far
    [actuator arm.SLDPRT, actuator assembly.SLDASM, actuator body.SLDPRT, actuator mounting bracket.SLDPRT, bounding plate.SLDPRT, central wheel plate.SLDPRT, distal E connector bracket.SLDPRT, end plate.SLDPRT]
2016-07-11 Added actuator files
    [actuator arm.SLDPRT, actuator assembly.SLDASM, actuator body.SLDPRT, actuator mounting bracket.SLDPRT]
2016-07-11 Variety of actuator file formats
    [actuator body.IGS, actuator body.x_t]
2016-07-11 Black Filter Trial
2016-07-12 Image -> Frame
2016-07-12 Black filter applied
2016-07-12 More file varieties
    [central wheel plate.SLDPRT, centralWheelPlate.IGS, distal E connector bracket.SLDPRT, distalEConnectorBracket.IGS, end wheel plate.SLDPRT, endWheelPlate.IGS, proximal actuator body support center.SLDPRT, proximal actuator body support side.SLDPRT]
2016-07-12 Frame resize
2016-07-12 Finished wheel, need to add feet
    [actuator assembly.SLDASM, actuatorBody.IGS, central wheel plate.SLDPRT, end wheel plate.SLDPRT, endWheelPlate.IGS, newFootAssemblyMiddleActuators.SLDASM, proximal actuator body support center.SLDPRT, proximal actuator body support side.SLDPRT]
2016-07-12 Add files via upload
    FINAL ASSEMBLED USE THIS
    [newFootAssemblyForEndActuators.SLDASM, newFootAssemblyMiddleActuators.SLDASM]
2016-07-12 Model reorganization
    [actuator assembly.SLDASM, actuator body.SLDPRT, actuatorAttachmentAssembly.SLDASM, bounding plate.DWG, central wheel plate.DWG, centralWheelPlate.DWG, centralWheelPlate.x_b, connectorToMidPlateAndEndPlate - Copy.DWG]
2016-07-13 New models, work on API
    [A-Spacer.SLDPRT, CentralActuatorSidePlate.SLDPRT, CentralActuatorSpanner.SLDPRT, ConnectingPlate.SLDPRT, OuterActuatorSidePlate.SLDPRT, OuterActuatorSpanner.SLDPRT, SpacerBoltConnector.SLDPRT, SpanningPlate.SLDPRT]
2016-07-13 Fix central wheel plate file
    [central wheel plate.SLDPRT]
2016-07-14 Added GUI control buttons
2016-07-15 Added foot laser cutting files
    [A-Spacer.SLDPRT, CentralActuatorSidePlate.SLDPRT, CentralActuatorSpanner.SLDPRT, ConnectingPlate.SLDPRT, OuterActuatorSidePlate.SLDPRT, OuterActuatorSpanner.SLDPRT, SpacerBoltConnector.SLDPRT, SpanningPlate.SLDPRT]
2016-07-19 changed Write to Arduino to Main
2016-07-19 this stuff works, and there's a demo for a single wheel
2016-07-19 Arm Animation
2016-07-19 added stepper motor control to Comms6
2016-07-19 stepper motor code works
2016-07-20 worked on moveArm in Arduino
2016-08-04 added a thing
    [Actuator Data.xlsx]
